olegv142/PhotoFinish/(commit log)

2013-03-05 Using 2 IR LEDs
2013-03-05 Restart detection to avoid false detect with opposite sign
    [finish.c]
2013-03-05 Reinitialize ADC on every measurement. Delay __delay_cycles(IR_DELAY) is introduced to reduce power-related parasitic signal.
2013-03-05 Yet another ADC readout improvement for more sensitivity
2013-03-05 Sensitivity improved - run multiple loops for short exposures
    [photosync.c]
2014-05-29 IR channel calibration - auto and manual
2014-12-04 Schematic doc update
2016-05-26 Revert "Don't send more pings till untill response receiving"
    This reverts commit a300f1f0097a51c901b84a9d7dae4ec0ea2c6121.
    [finish.c, start.c]
2016-05-26 Allow start to reset finish module while its waiting for finishing
    [finish.c]
2016-06-02 Always wait button press
2016-10-11 Battery sensing via external input
2016-10-25 Transmit finish time to UART
